rummanwaqar/self-balancing-robot/docs/README.md

# Index

* [Research material](research.md)
