rummanwaqar/self-balancing-robot/docs/research.md

# Research

## Self balancing robots

* [#35 Inside an Autonomous Self Balancing Robot #1 (Tutorial)](https://www.youtube.com/watch?v=s5m-DTn8jyw)
* [Self balancing robot](http://www.x-firm.com/?page_id=148)
* [Balancing robot arduino](https://barrettsprojects.wordpress.com/2014/03/11/balancing-robot-arduino/)
* [Self balancing github](https://github.com/SensorsIot/Self-Balancing-Robot)

## IMU
* [6DOF & 9DOF Sensor Fusion with Madgwick's Filter, MPU6050, HMC5883L (GY-86 Module)](https://www.youtube.com/watch?v=WqQ3HZCI3nA)
* [Madgwick Filter](http://x-io.co.uk/open-source-imu-and-ahrs-algorithms/)
* [OpenIMU repository](https://github.com/hustcalm/OpenIMUFilter)
* [MPU6050 datasheet](https://store.invensense.com/datasheets/invensense/MPU-6050_DataSheet_V3%204.pdf)
* [Ep. 57 Arduino Accelerometer & Gyroscope Tutorial MPU-6050 6DOF Module](https://www.youtube.com/watch?v=M9lZ5Qy5S2s&t=1090s)
* [MPU-6050 6dof IMU tutorial for auto-leveling quadcopters with Arduino source code](https://www.youtube.com/watch?v=4BoIE8YQwM8)
* [Tutorial: Gyroscope and Accelerometer (GY-521/MPU6050) with Arduino](https://www.youtube.com/watch?v=wTfSfhjhAU0)

## Quadrature Encoders
* [1x 2x and 4x encoding](https://www.motioncontroltips.com/faq-what-do-x1-x2-and-x4-position-encoding-mean-for-incremental-encoders/)
* [Encoders](https://tutorial.cytron.io/2012/01/17/quadrature-encoder/)
* [Quadrature Encoders](http://www.helicron.net/avr/quadrature-decoders/)
* [Implementation](https://cdn.sparkfun.com/datasheets/Robotics/How%20to%20use%20a%20quadrature%20encoder.pdf)

## HC-08 BLE
* [BLE Linux](https://www.jaredwolff.com/blog/get-started-with-bluetooth-low-energy/)
* [Java BLE](https://www.shortn0tes.com/2017/08/uart-bridge-from-hm-10-to-pc-with-java.html)
