rummanwaqar/self-balancing-robot/schematic/self_balancing_robot_v1_sch.png

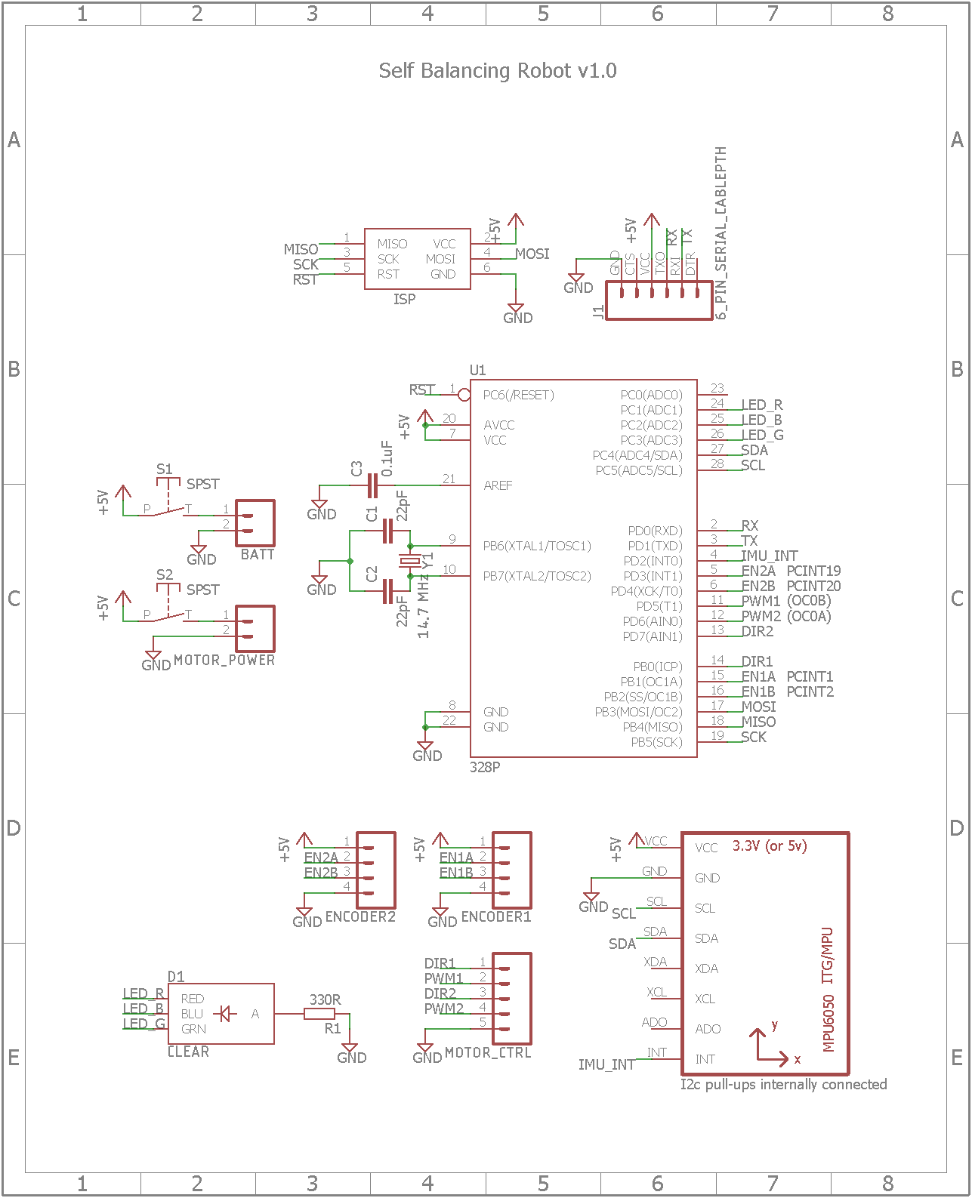
schematic/self_balancing_robot_v1_sch.png
