rummanwaqar/self-balancing-robot/mechanical/motor_assembly.SLDASM

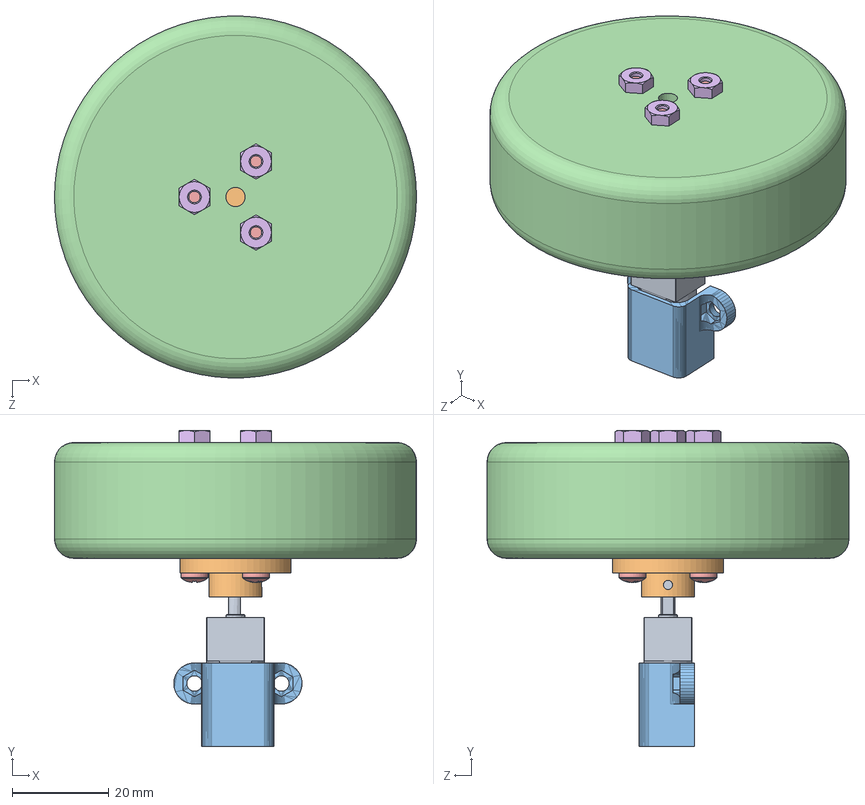
[picture p2: CAD file, 2018-04-06]
mechanical/motor_assembly.SLDASM
75.0 x 65.5 x 75.0 mm
01_micro_metal_gearmotor
02_motor_hub
03_motor_mount
04_wheel
pan cross head_ai x 3
machine screw nut hex_ai x 3
