rummanwaqar/self-balancing-robot/mechanical/main.SLDASM

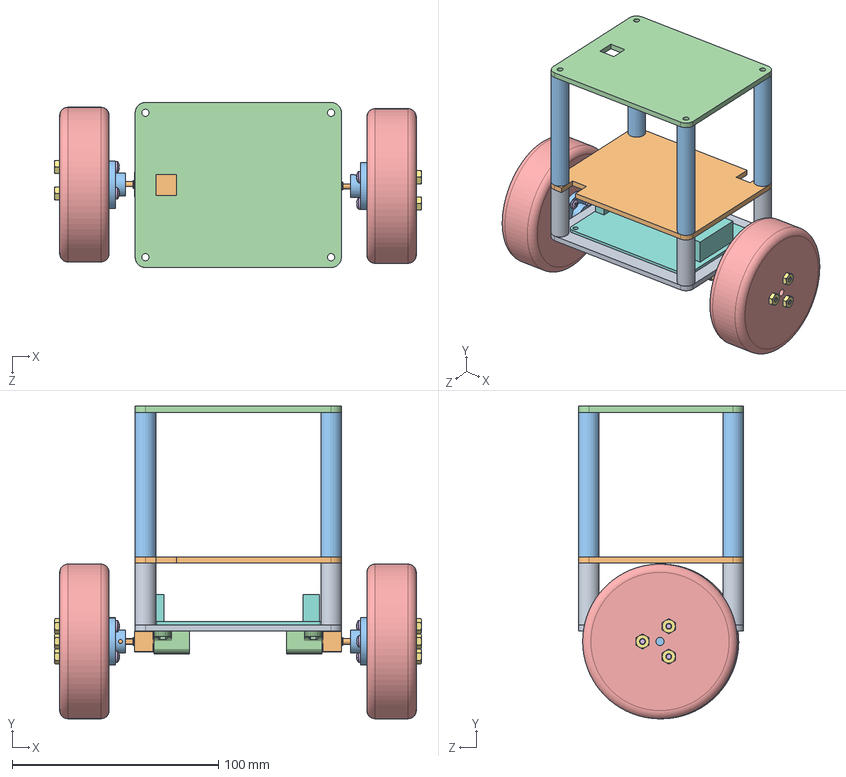
[picture p3: CAD file, 2018-04-06]
mechanical/main.SLDASM
177.9 x 151.5 x 80.0 mm
05_plate_0
01_micro_metal_gearmotor x 2
02_motor_hub x 2
03_motor_mount x 2
04_wheel x 2
pan cross head_ai x 6
machine screw nut hex_ai x 6
06_mdd10a
07_rod_3mm x 4
05_plate_1
07_rod_7mm x 4
05_plate_2
