rummanwaqar/self-balancing-robot/mechanical/07_rod_7mm.SLDPRT

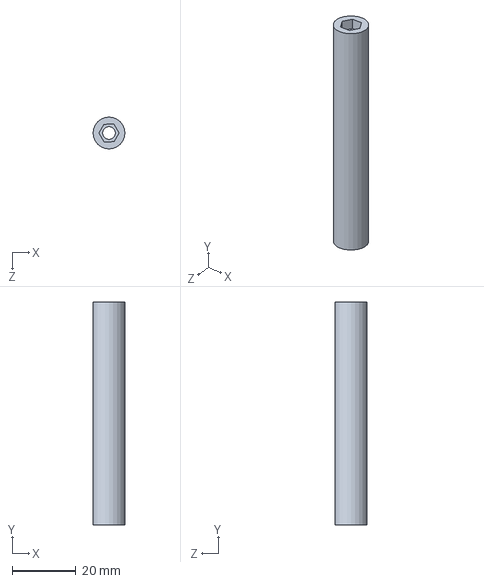
[picture p4: CAD file, 2018-04-06]
mechanical/07_rod_7mm.SLDPRT
10.0 x 70.0 x 10.0 mm
