rummanwaqar/self-balancing-robot/mechanical/04_wheel.SLDPRT

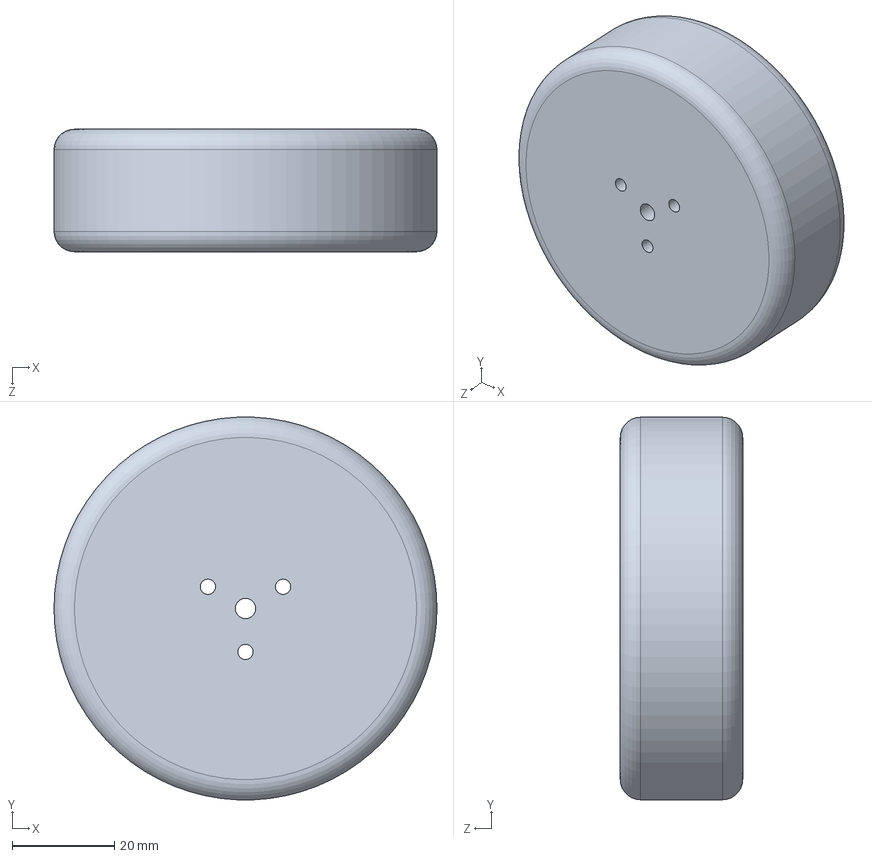
[picture p5: CAD file, 2018-04-06]
mechanical/04_wheel.SLDPRT
75.0 x 74.9 x 24.0 mm
