rummanwaqar/self-balancing-robot/mechanical/05_plate_2.SLDPRT

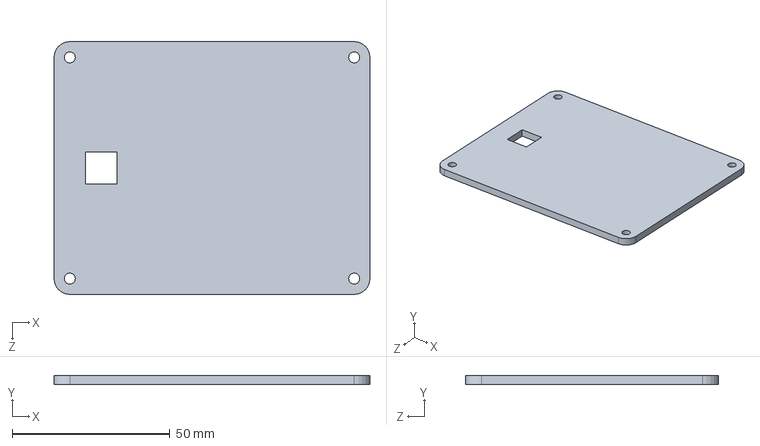
[picture p6: CAD file, 2018-04-06]
mechanical/05_plate_2.SLDPRT
100.0 x 3.00 x 80.0 mm
