rummanwaqar/self-balancing-robot/mechanical/02_motor_hub.SLDPRT

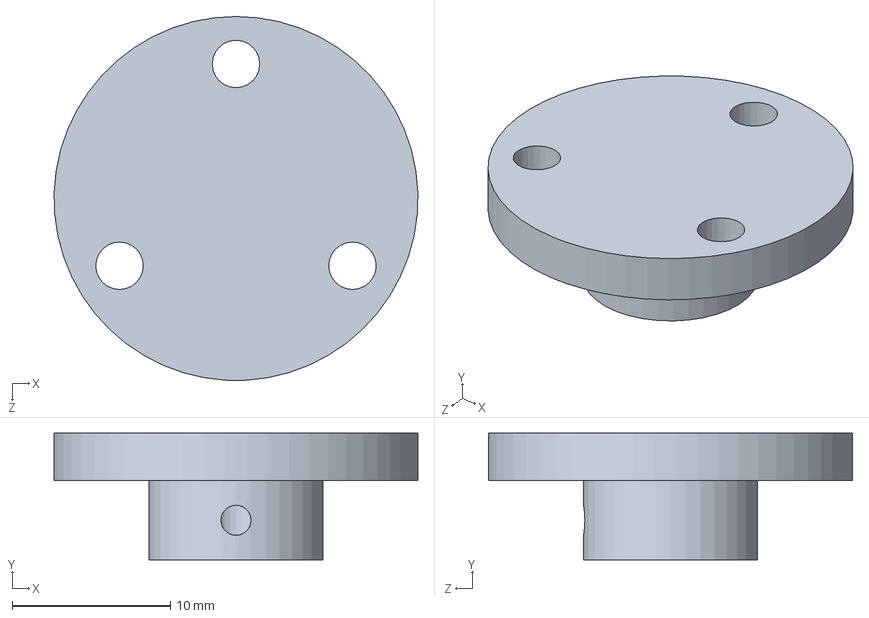
[picture p7: CAD file, 2018-04-06]
mechanical/02_motor_hub.SLDPRT
23.0 x 8.00 x 23.0 mm
