rummanwaqar/self-balancing-robot/mechanical/03_motor_mount.SLDPRT

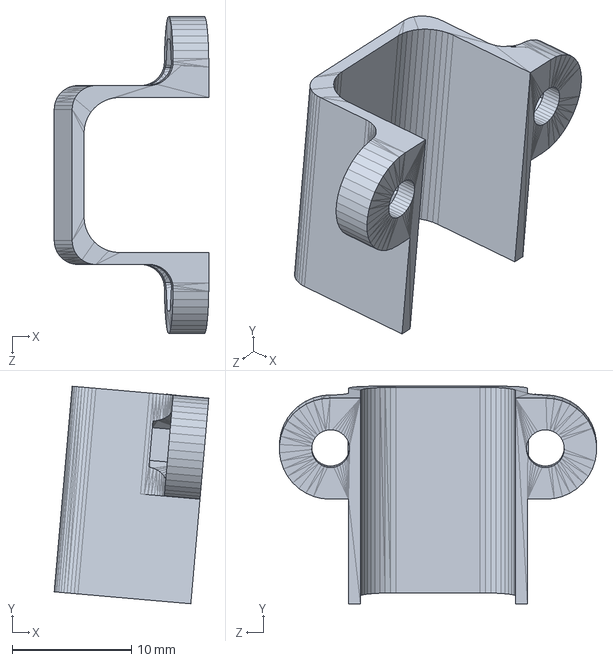
[picture p8: CAD file, 2018-04-06]
mechanical/03_motor_mount.SLDPRT
13.0 x 18.2 x 26.6 mm
