rummanwaqar/self-balancing-robot/mechanical/01_micro_metal_gearmotor.SLDPRT

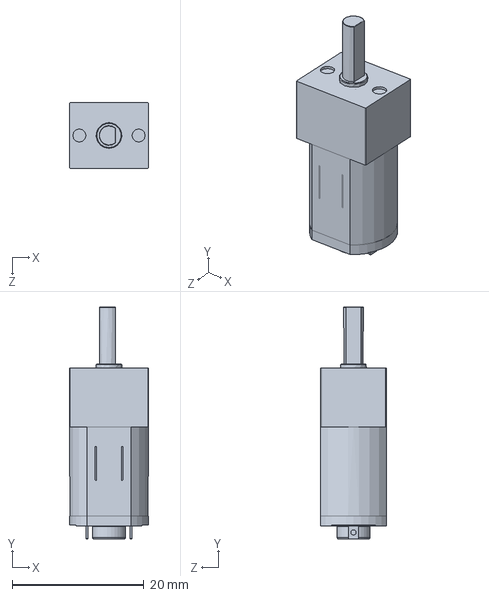
[picture p9: CAD file, 2018-04-06]
mechanical/01_micro_metal_gearmotor.SLDPRT
12.0 x 35.3 x 10.0 mm
