rummanwaqar/self-balancing-robot/mechanical/07_rod_3mm.SLDPRT

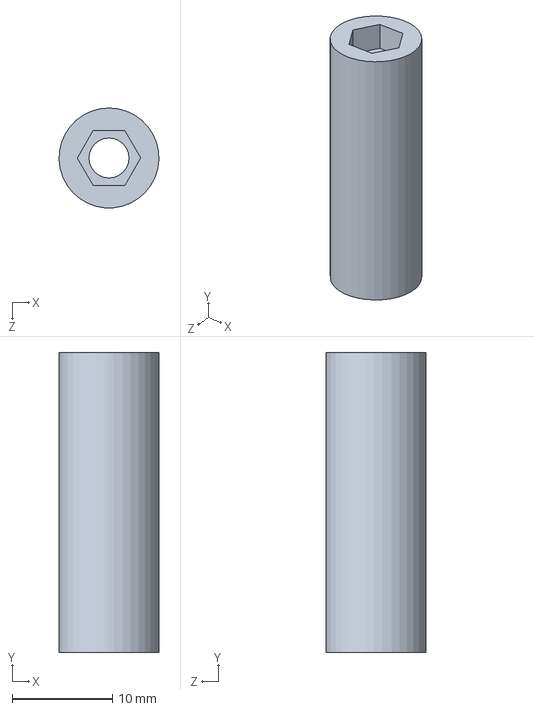
[picture p11: CAD file, 2018-04-06]
mechanical/07_rod_3mm.SLDPRT
9.99 x 30.0 x 10.0 mm
