rummanwaqar/self-balancing-robot/mechanical/06_mdd10a.SLDPRT

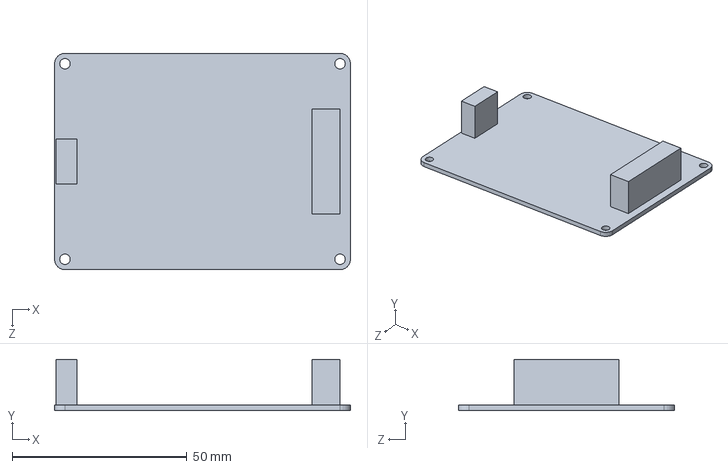
[picture p12: CAD file, 2018-04-06]
mechanical/06_mdd10a.SLDPRT
84.8 x 14.7 x 62.0 mm
