rummanwaqar/self-balancing-robot/(list of files, cad)

Other CAD files:
mechanical/Assem1.SLDASM
mechanical/05_plate_1.SLDPRT
mechanical/exports/02_motor_hub.STL
mechanical/exports/03_motor_mount.STL
mechanical/exports/05_plate_0.STL
mechanical/exports/05_plate_1.STL
mechanical/exports/05_plate_2.STL
mechanical/exports/07_rod_3mm.STL
mechanical/exports/07_rod_7mm.STL
