rummanwaqar/self-balancing-robot/schematic/self_balancing_robot_v1.sch

## EAGLE design schematic/self_balancing_robot_v1.sch (2018-04-03)

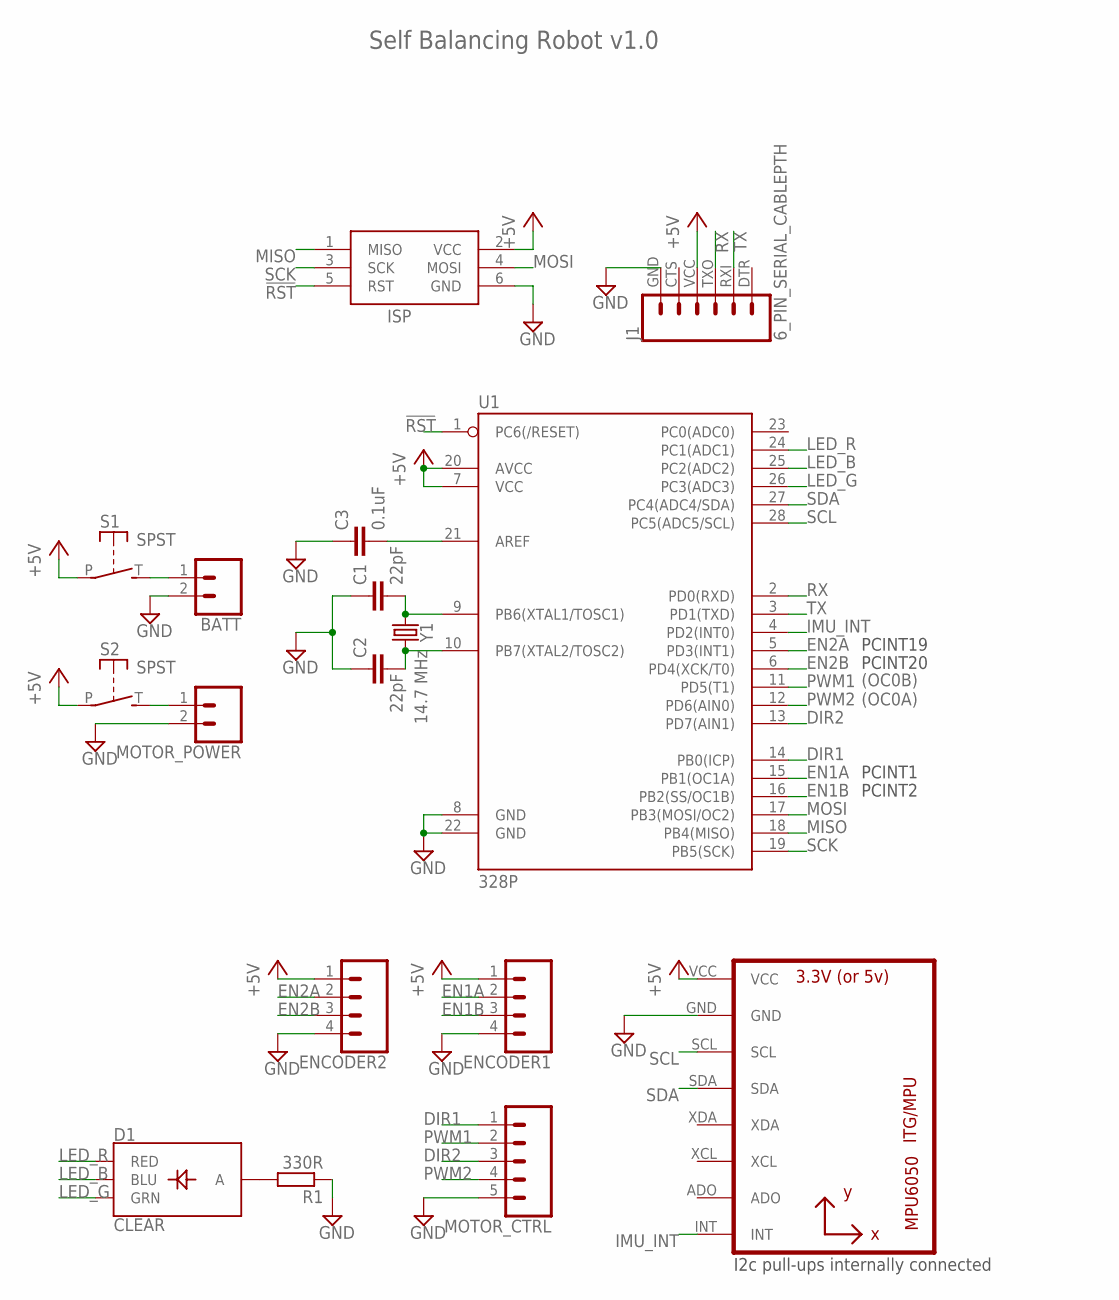
[picture p13: schematic self_balancing_robot_v1.sch]

Parts:
BATT: CONN_02; 1X02
C1, C2: 22pF; C025-025X050
C3: 0.1uF; C025-025X050
D1: CLEAR; LED-RGB-THRU
ENCODER1, ENCODER2: CONN_04LONGPADS; 1X04_LONGPADS
ISP: AVRISP-BOX
J1: 6_PIN_SERIAL_CABLEPTH; FTDI_BASIC
MOTOR_CTRL: CONN_05PTH_LONGPADS; 1X05_LONGPADS
MOTOR_POWER: CONN_02; 1X02
R1: 330R; 0207/10
S1, S2: SPST; JUDCOSPST
U1: 328P; DIP28
U2: GY-521MPU6050; GY-521
Y1: 14.7 MHz; HC49U

Connections:
!RST: ISP.5 (RST), U1.1 (PC6(/RESET))
+5V: ENCODER1.1, ENCODER2.1, ISP.2 (VCC), J1.VCC (4), U1.7 (VCC), U1.20 (AVCC), U2.VCC
+7V: S1.P, S2.P
DIR1: MOTOR_CTRL.1, U1.14 (PB0(ICP))
DIR2: MOTOR_CTRL.3, U1.13 (PD7(AIN1))
EN1A: ENCODER1.2, U1.15 (PB1(OC1A))
EN1B: ENCODER1.3, U1.16 (PB2(SS/OC1B))
EN2A: ENCODER2.2, U1.5 (PD3(INT1))
EN2B: ENCODER2.3, U1.6 (PD4(XCK/T0))
GND: BATT.2, C1.1, C2.1, C3.1, ENCODER1.4, ENCODER2.4, ISP.6 (GND), J1.GND (6), MOTOR_CTRL.5, MOTOR_POWER.2, R1.1, U1.8 (GND), U1.22 (GND), U2.GND
IMU_INT: U1.4 (PD2(INT0)), U2.INT
LED_B: D1.4 (BLU), U1.25 (PC2(ADC2))
LED_G: D1.3 (GRN), U1.26 (PC3(ADC3))
LED_R: D1.1 (RED), U1.24 (PC1(ADC1))
MISO: ISP.1 (MISO), U1.18 (PB4(MISO))
MOSI: ISP.4 (MOSI), U1.17 (PB3(MOSI/OC2))
unnamed: C2.2, U1.10 (PB7(XTAL2/TOSC2)), Y1.2
unnamed: C1.2, U1.9 (PB6(XTAL1/TOSC1)), Y1.1
unnamed: D1.2 (A), R1.2
unnamed: C3.2, U1.21 (AREF)
unnamed: BATT.1, S1.T (S)
unnamed: MOTOR_POWER.1, S2.T (S)
PWM1: MOTOR_CTRL.2, U1.11 (PD5(T1))
PWM2: MOTOR_CTRL.4, U1.12 (PD6(AIN0))
RX: J1.TXO (3), U1.2 (PD0(RXD))
SCK: ISP.3 (SCK), U1.19 (PB5(SCK))
SCL: U1.28 (PC5(ADC5/SCL)), U2.SCL
SDA: U1.27 (PC4(ADC4/SDA)), U2.SDA
TX: J1.RXI (2), U1.3 (PD1(TXD))

Notes on the sheet:
(OC0B) (OC0A)
Self Balancing Robot v1.0
PCINT19
PCINT20
PCINT1
PCINT2
