rummanwaqar/self-balancing-robot/docs/hc-08_params.txt

Address = 58:7a:62:4f:60:44
Service UUID = 0000FFE0-0000-1000-8000-00805F9B34FB
Char UUID = 0000FFE1-0000-1000-8000-00805F9B34FB
