rummanwaqar/self-balancing-robot/(commit log)

2018-03-29 Added v1.0 of schematic
    [self_balancing_robot_v1.sch]
2018-03-29 Updated with part values
    [self_balancing_robot_v1.sch]
2018-03-30 Started firmware (blink led)
2018-03-30 Added basic uart
2018-03-30 Added i2c + some encoder tests
2018-03-30 Basic encoder interrupts
2018-03-31 removed i2c_master.c
2018-03-31 Basic raw accel, gyro works
2018-03-31 basic imu working
2018-04-01 encoders work
2018-04-01 motor speed cleaned up
2018-04-01 encoder calc with constants
2018-04-01 motor speed working
2018-04-01 motor set speed 0-100
2018-04-01 changed to 4x encoders + encoder count
2018-04-01 updated schematic for ENC change
    [self_balancing_robot_v1.sch]
2018-04-01 updated motor table for positive values
2018-04-01 moved velocity timer to main
2018-04-01 pid flag
2018-04-01 Fixed misc include issue
    [main.c]
2018-04-03 Basic imu working with calibration
2018-04-03 moved sample time to define
2018-04-03 implemented madgwick filter
2018-04-03 updated schematic with INT pin for IMU
    [self_balancing_robot_v1.sch]
2018-04-03 fixed motor node
2018-04-03 Added motor commands
2018-04-03 encoder lpf and pid tuning
2018-04-03 Added LED stuff
2018-04-04 fixed display bug + crude pitch control
    [main.c]
2018-04-06 Added mechanical stuff
    [01_micro_metal_gearmotor.SLDPRT, 02_motor_hub.SLDPRT, 02_motor_hub.STL, 03_motor_mount.SLDPRT, 03_motor_mount.STL, 04_wheel.SLDPRT, 05_plate_0.SLDPRT, 05_plate_0.STL]
2018-04-09 added placeholder for pitch PID
2018-04-10 PID pitch control
2018-04-11 pitch controller
